Jana-Marie/OtterControlNG/README.md

# OttercontrolNG

Next generation of OtterControl, based on the STM32G431 and STMBL. Increased power density though an aluminum PCB power stage.

(not 100% working/tested yet, firmware to be released soon)

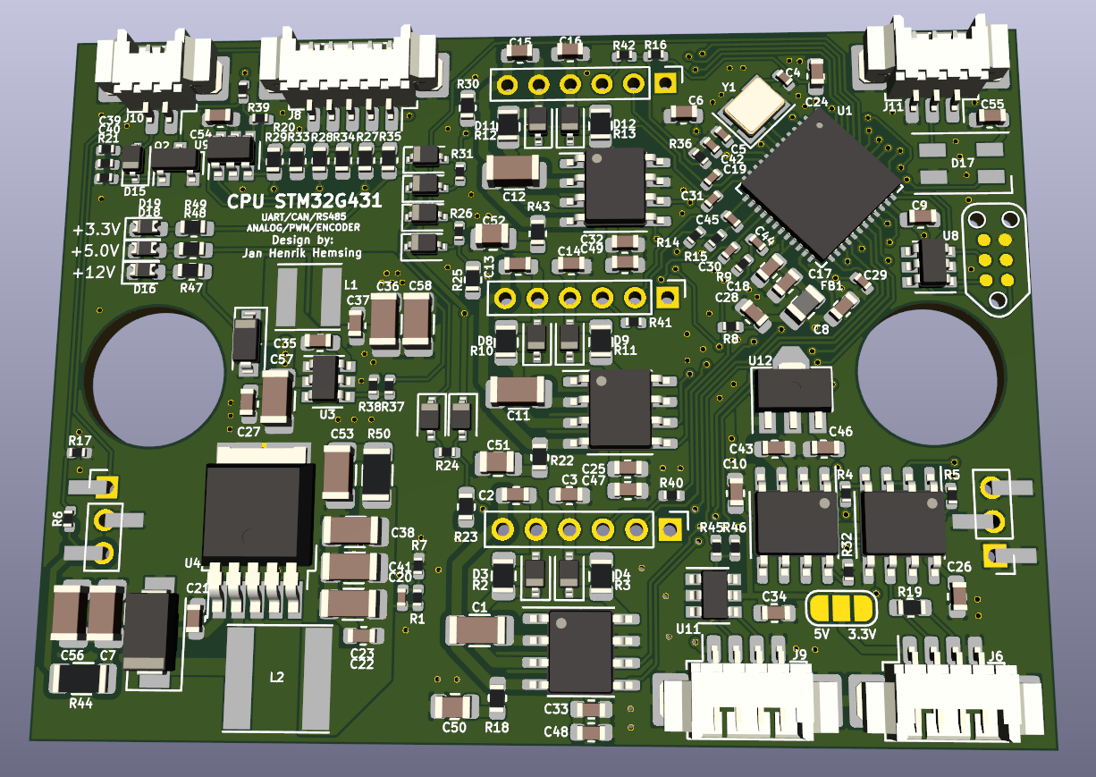
[picture p1: STM32G431/STM32G431.png]


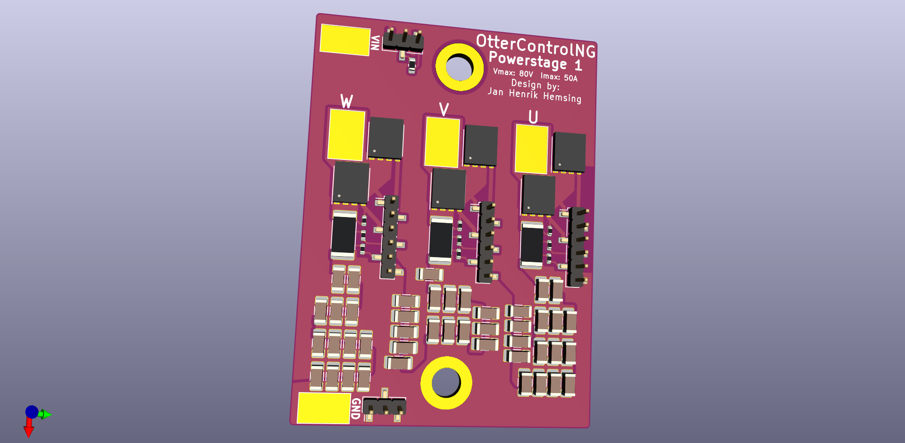
[picture p2: AluPCB/AluPCB_PowerStage1_1.png]
