Jana-Marie/OtterControlNG/AluPCB/README.md

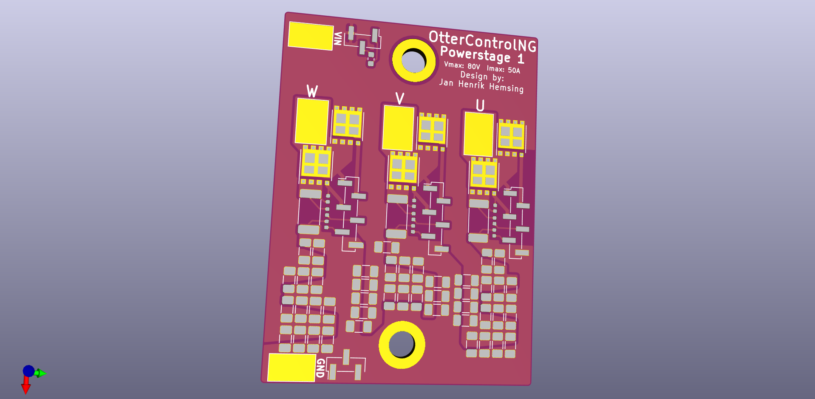
[picture p3: AluPCB/AluPCB_PowerStage1_2.png]
