Jana-Marie/OtterControlNG/(list of files, cad)

Other CAD files:
AluPCB/AluPCB-F_Paste_100.dxf
AluPCB/AluPCB-F_Paste_80.dxf
AluPCB/AluPCB-F_Paste_90.dxf
