Jana-Marie/OtterControlNG/STM32G431/con-Connector, Resistors and ICs.pdf

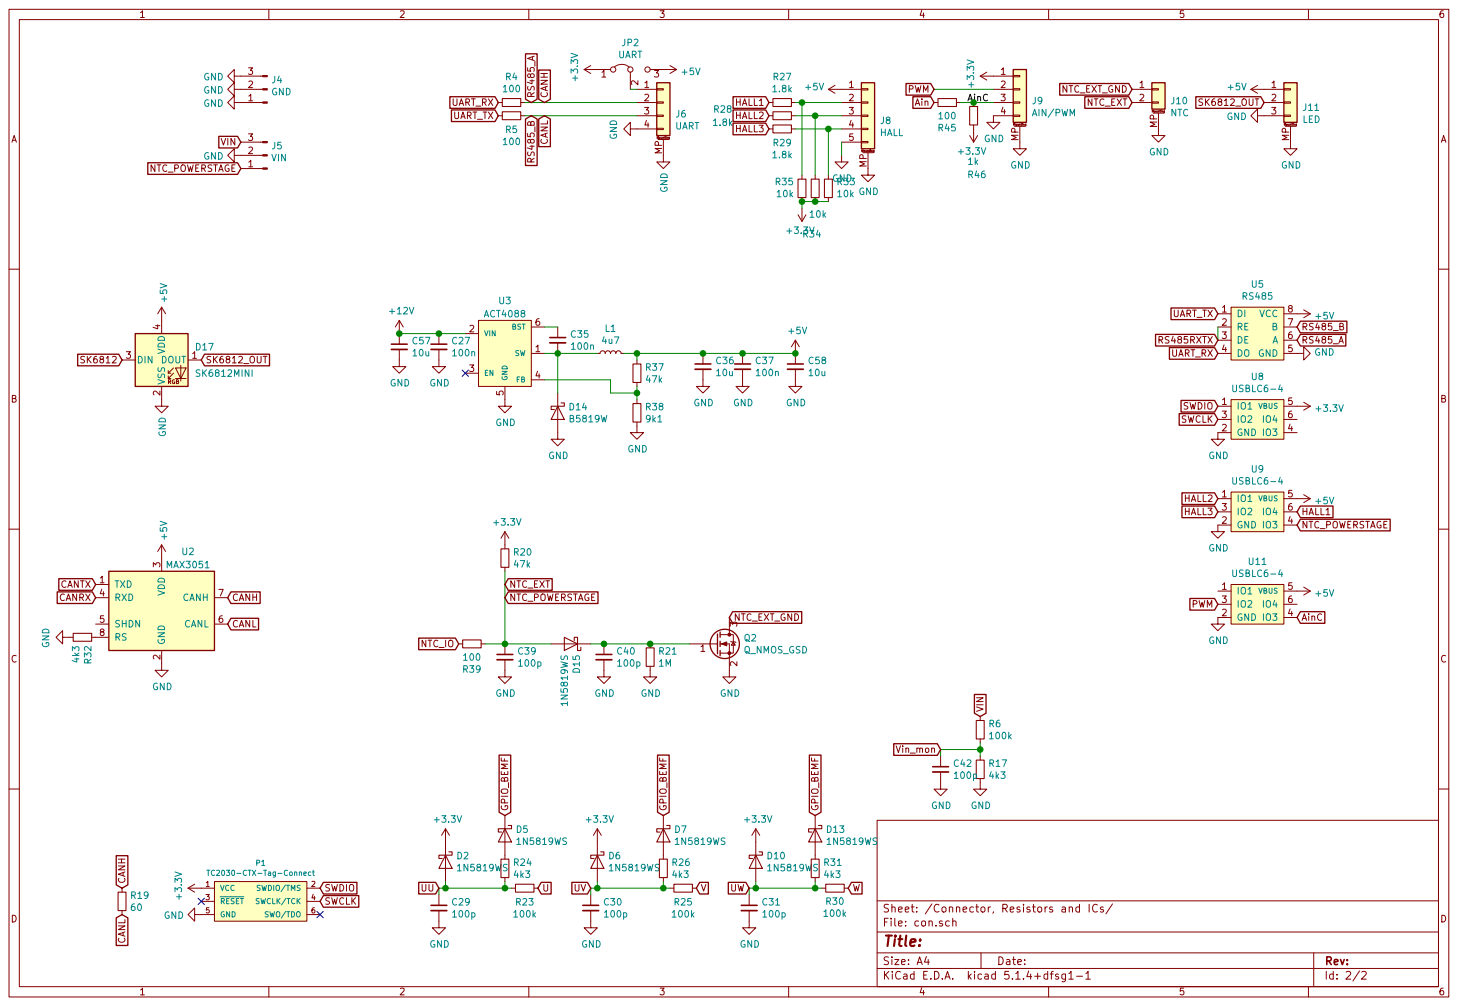
[picture p4: page 1]

3 RXD 4 SHDN 5 CANL 6 CANH 7 RS 8 U2 MAX3051 R34

Id: 2/2 Title: File: con.sch Sheet: /Connector, Resistors and ICs/
