Jana-Marie/OtterControlNG/STM32G431/STM32G431.pdf

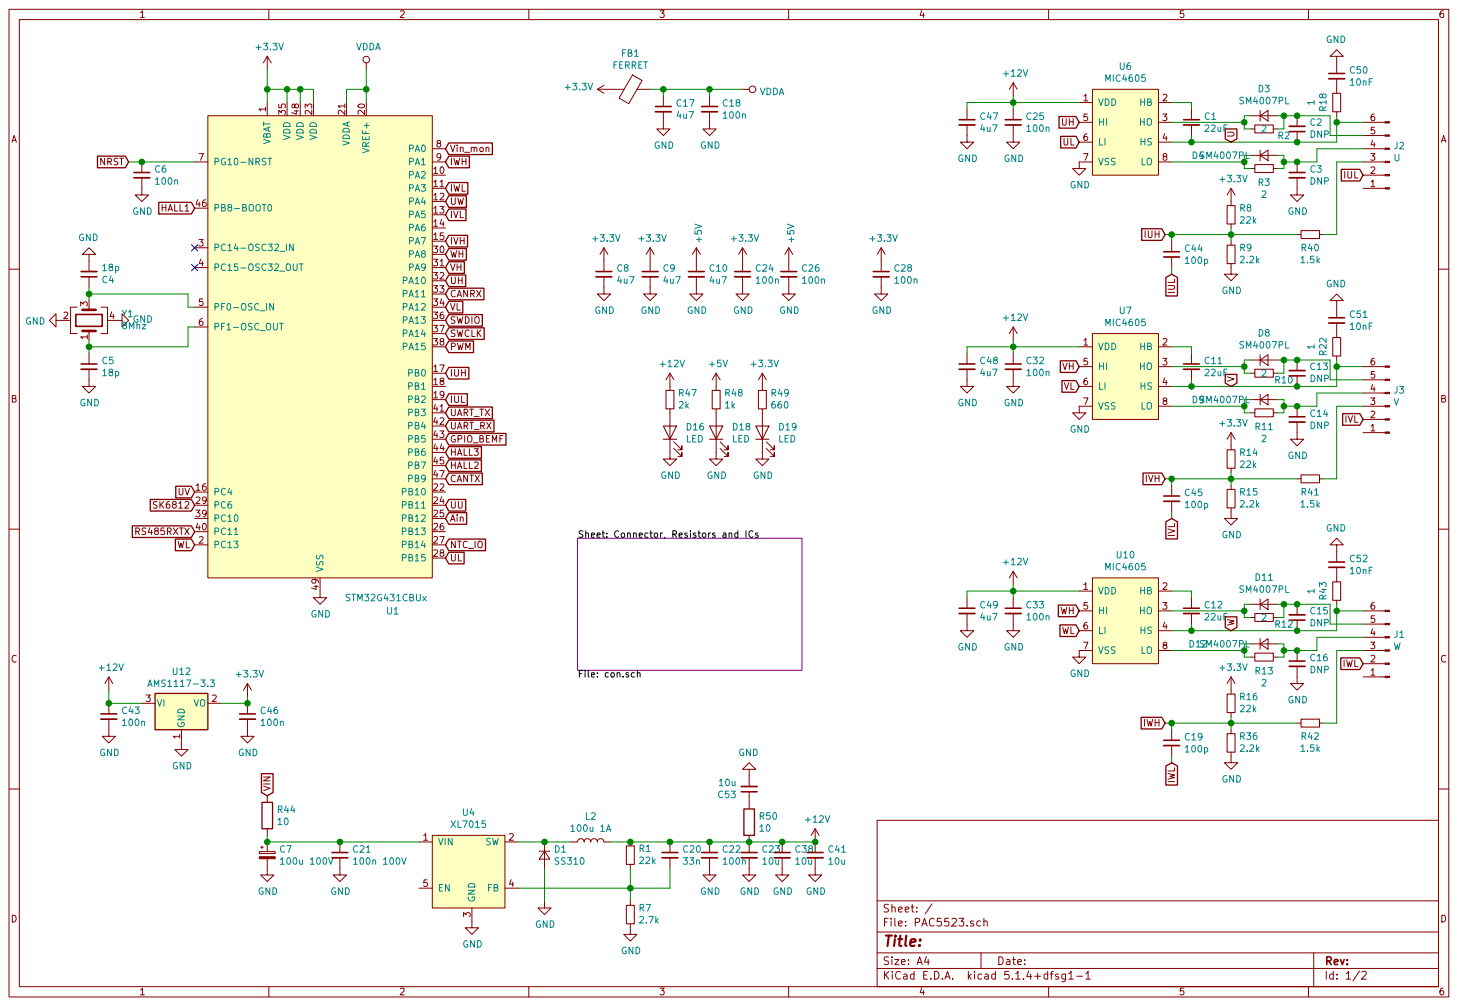
[picture p5: page 1]

1 PA2 10 PA3 11 PA4 12 PA5 13 PA6 14 PA7 15 PC4 16 PB0 17 PB1 18 PB2 19 PC13 2 VREF+ 20 VDDA 21 PB10 22 VDD 23 PB11 24 PB12 25 PB13 26 PB14 27 PB15 28 PC6 29 PC14-OSC32_IN 3 PA8 30 PA9 31 PA10 32 PA11 33 PA12 34 VDD 35 PA13 36 PA14 37 PA15 38 PC10 39 PC15-OSC32_OUT 4 PC11 40 PB3 41 PB4 42 PB5 43 PB6 44 PB7 45 PB8-BOOT0 46 PB9 47 VDD 48 VSS 49 PF0-OSC_IN 5 PF1-OSC_OUT 6 PG10-NRST 7 PA0 8 PA1 9 U1 STM32G431CBUx

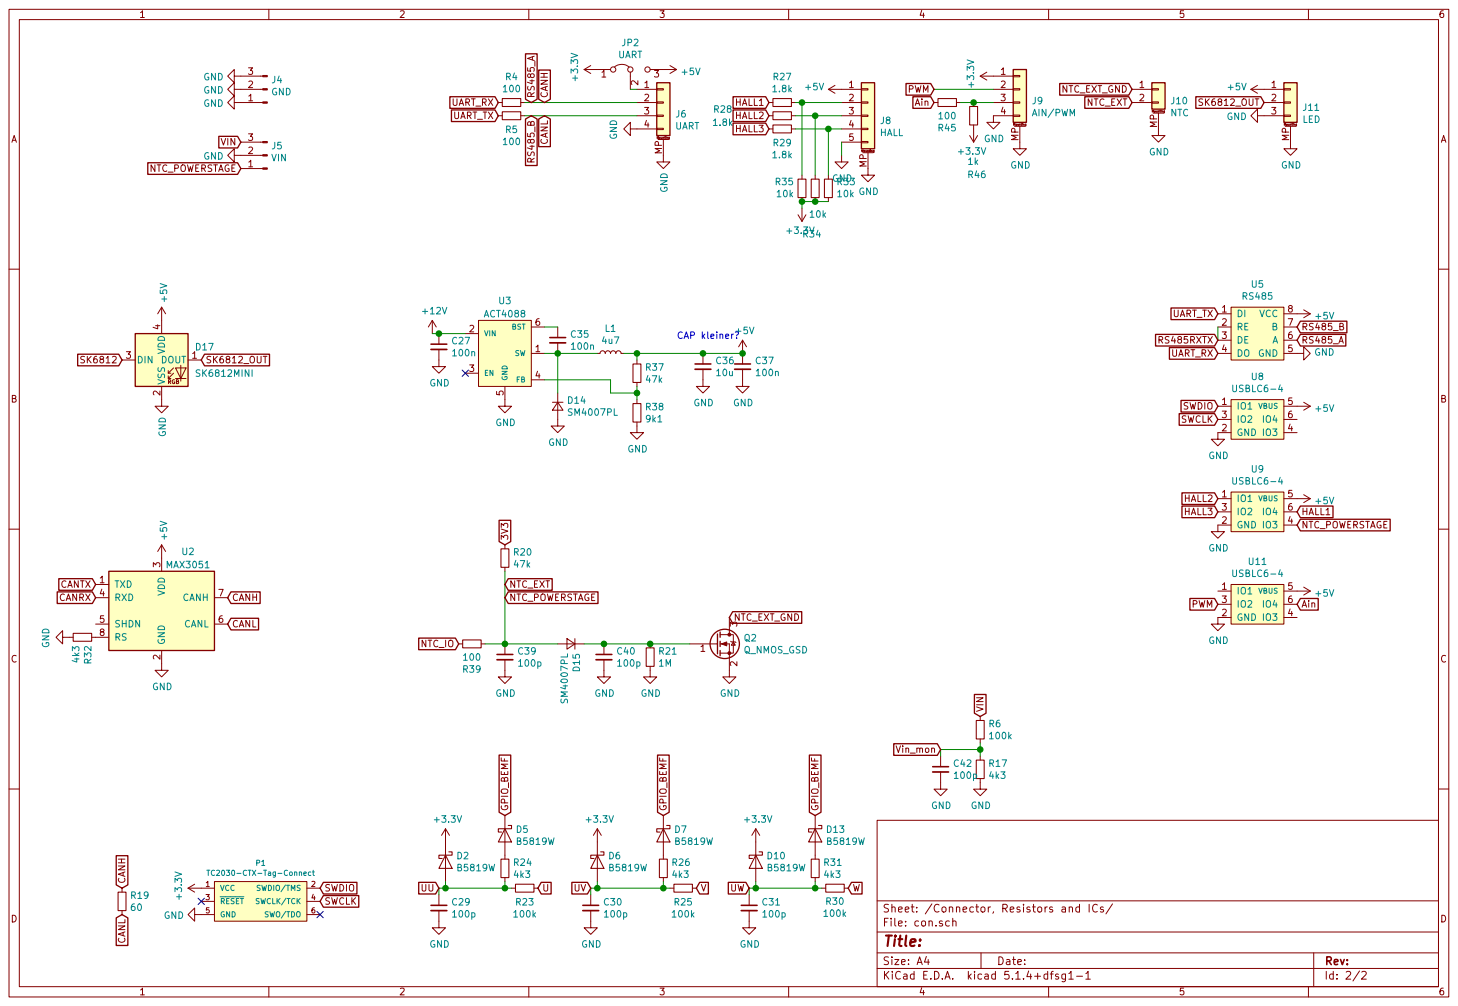
[picture p6: page 2]

3 RXD 4 SHDN 5 CANL 6 CANH 7 RS 8 U2 MAX3051 GND
