Jana-Marie/OtterControlNG/PAC5523/PAC5523.pdf

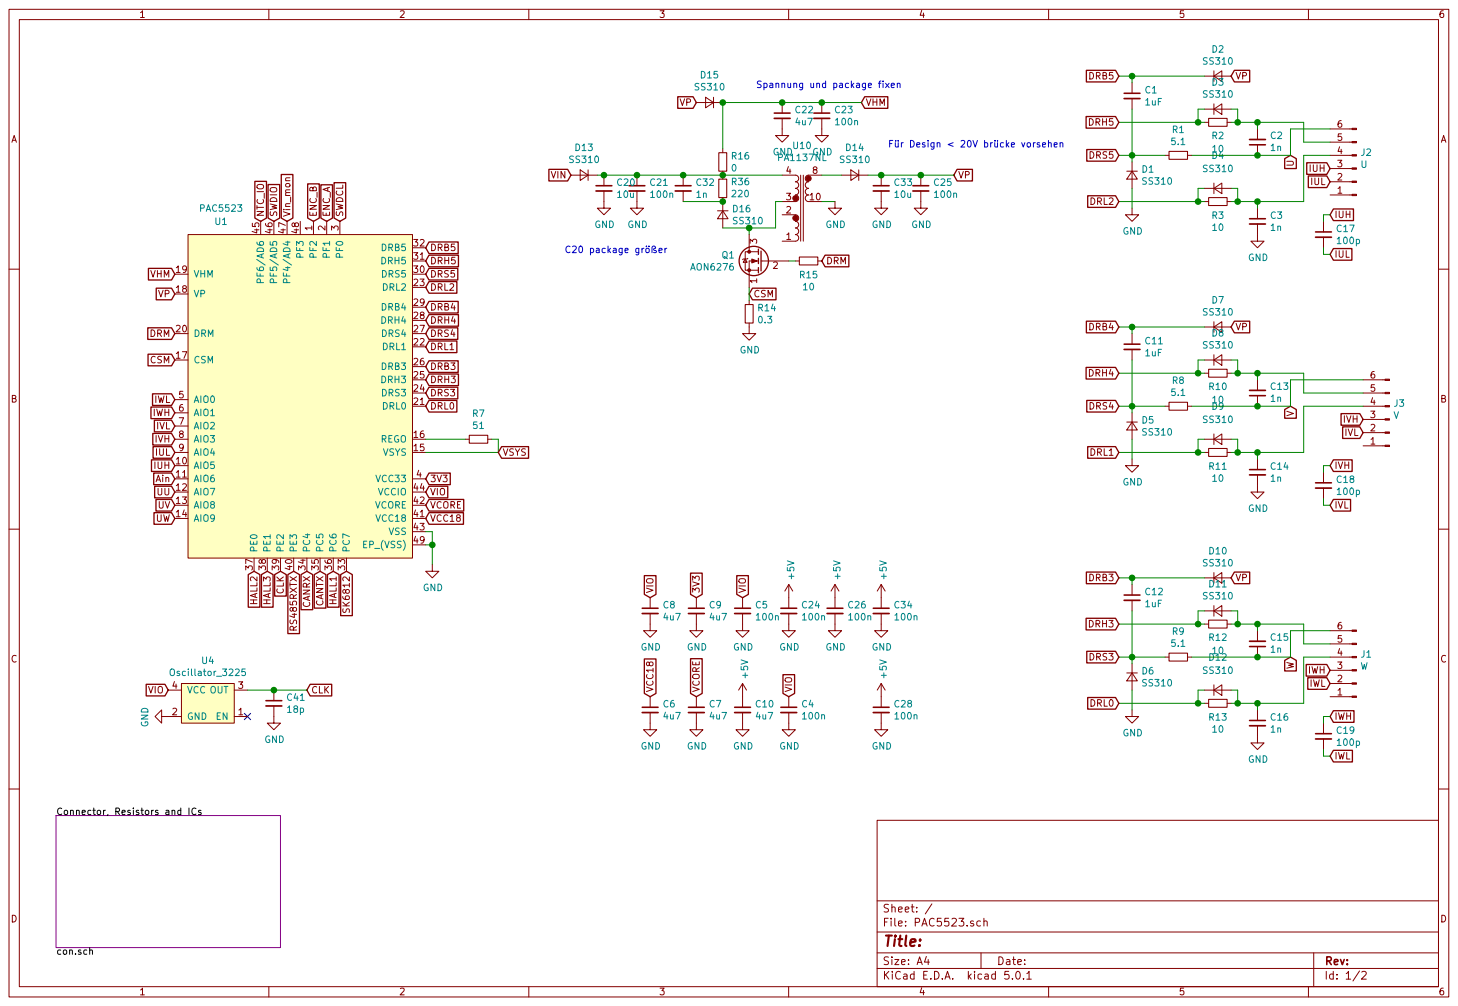
[picture p7: page 1]

Spannung und package fixen

Für Design < 20V brücke vorsehen

1 AIO5 10 AIO6 11 AIO7 12 AIO8 13 AIO9 14 VSYS 15 REGO 16 CSM 17 VP 18 VHM 19 PF1

Id: 1/2 Title: File: PAC5523.sch Sheet: / PF2

4u7 Connector, Resistors and ICs

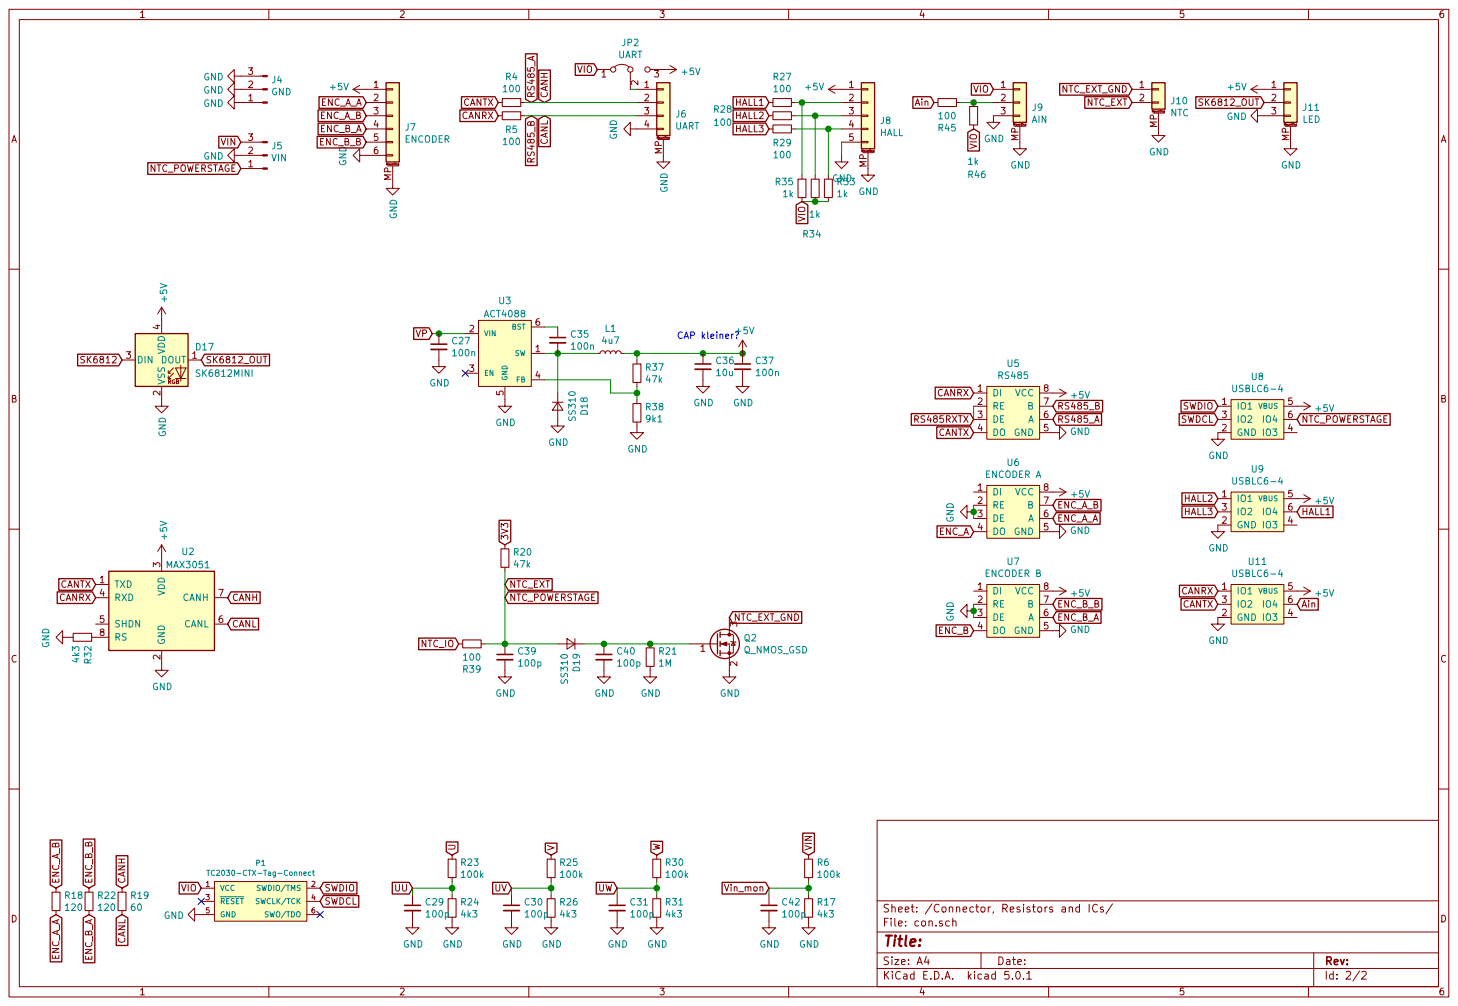
[picture p8: page 2]

JP2 UART GND GND GND

Ain GND GND GND

3 RXD 4 SHDN 5 CANL 6 CANH 7 RS 8 U2 MAX3051 GND 4k3 R32 GND

Id: 2/2 Title: File: con.sch Sheet: /Connector, Resistors and ICs/
