Jana-Marie/OtterControlNG/AluPCB/AluPCB.pdf

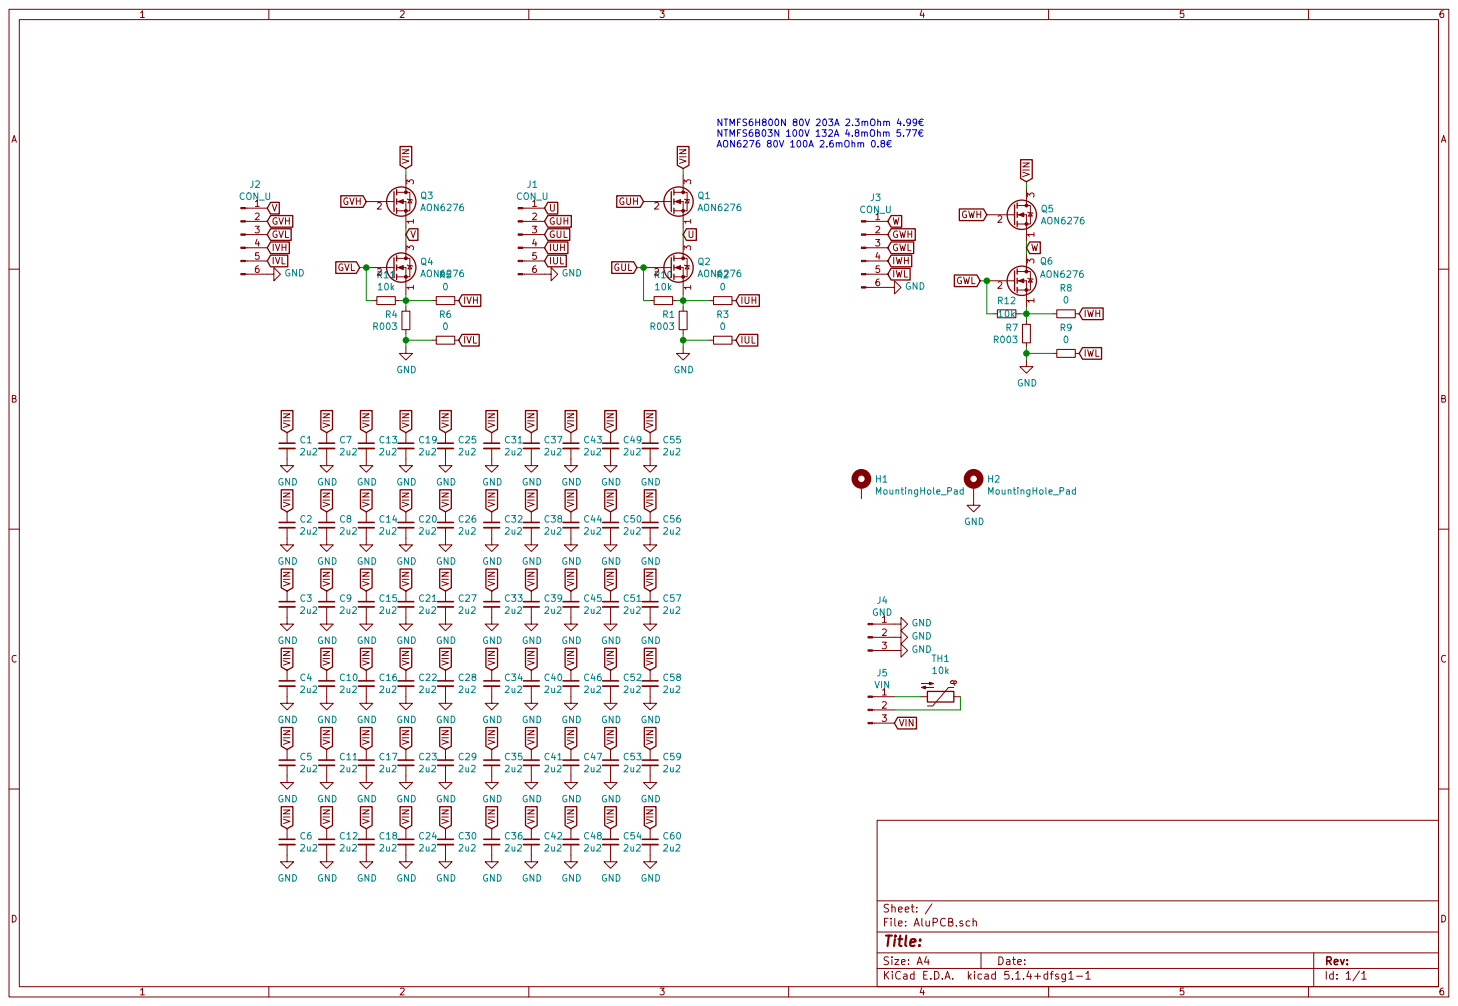
[picture p12: page 1]

Id: 1/1 Title: File: AluPCB.sch Sheet: /
