Jana-Marie/OtterControlNG/STM32G431/STM32G431.kicad_pcb

## KiCad design STM32G431/STM32G431.kicad_pcb (2020-01-31)

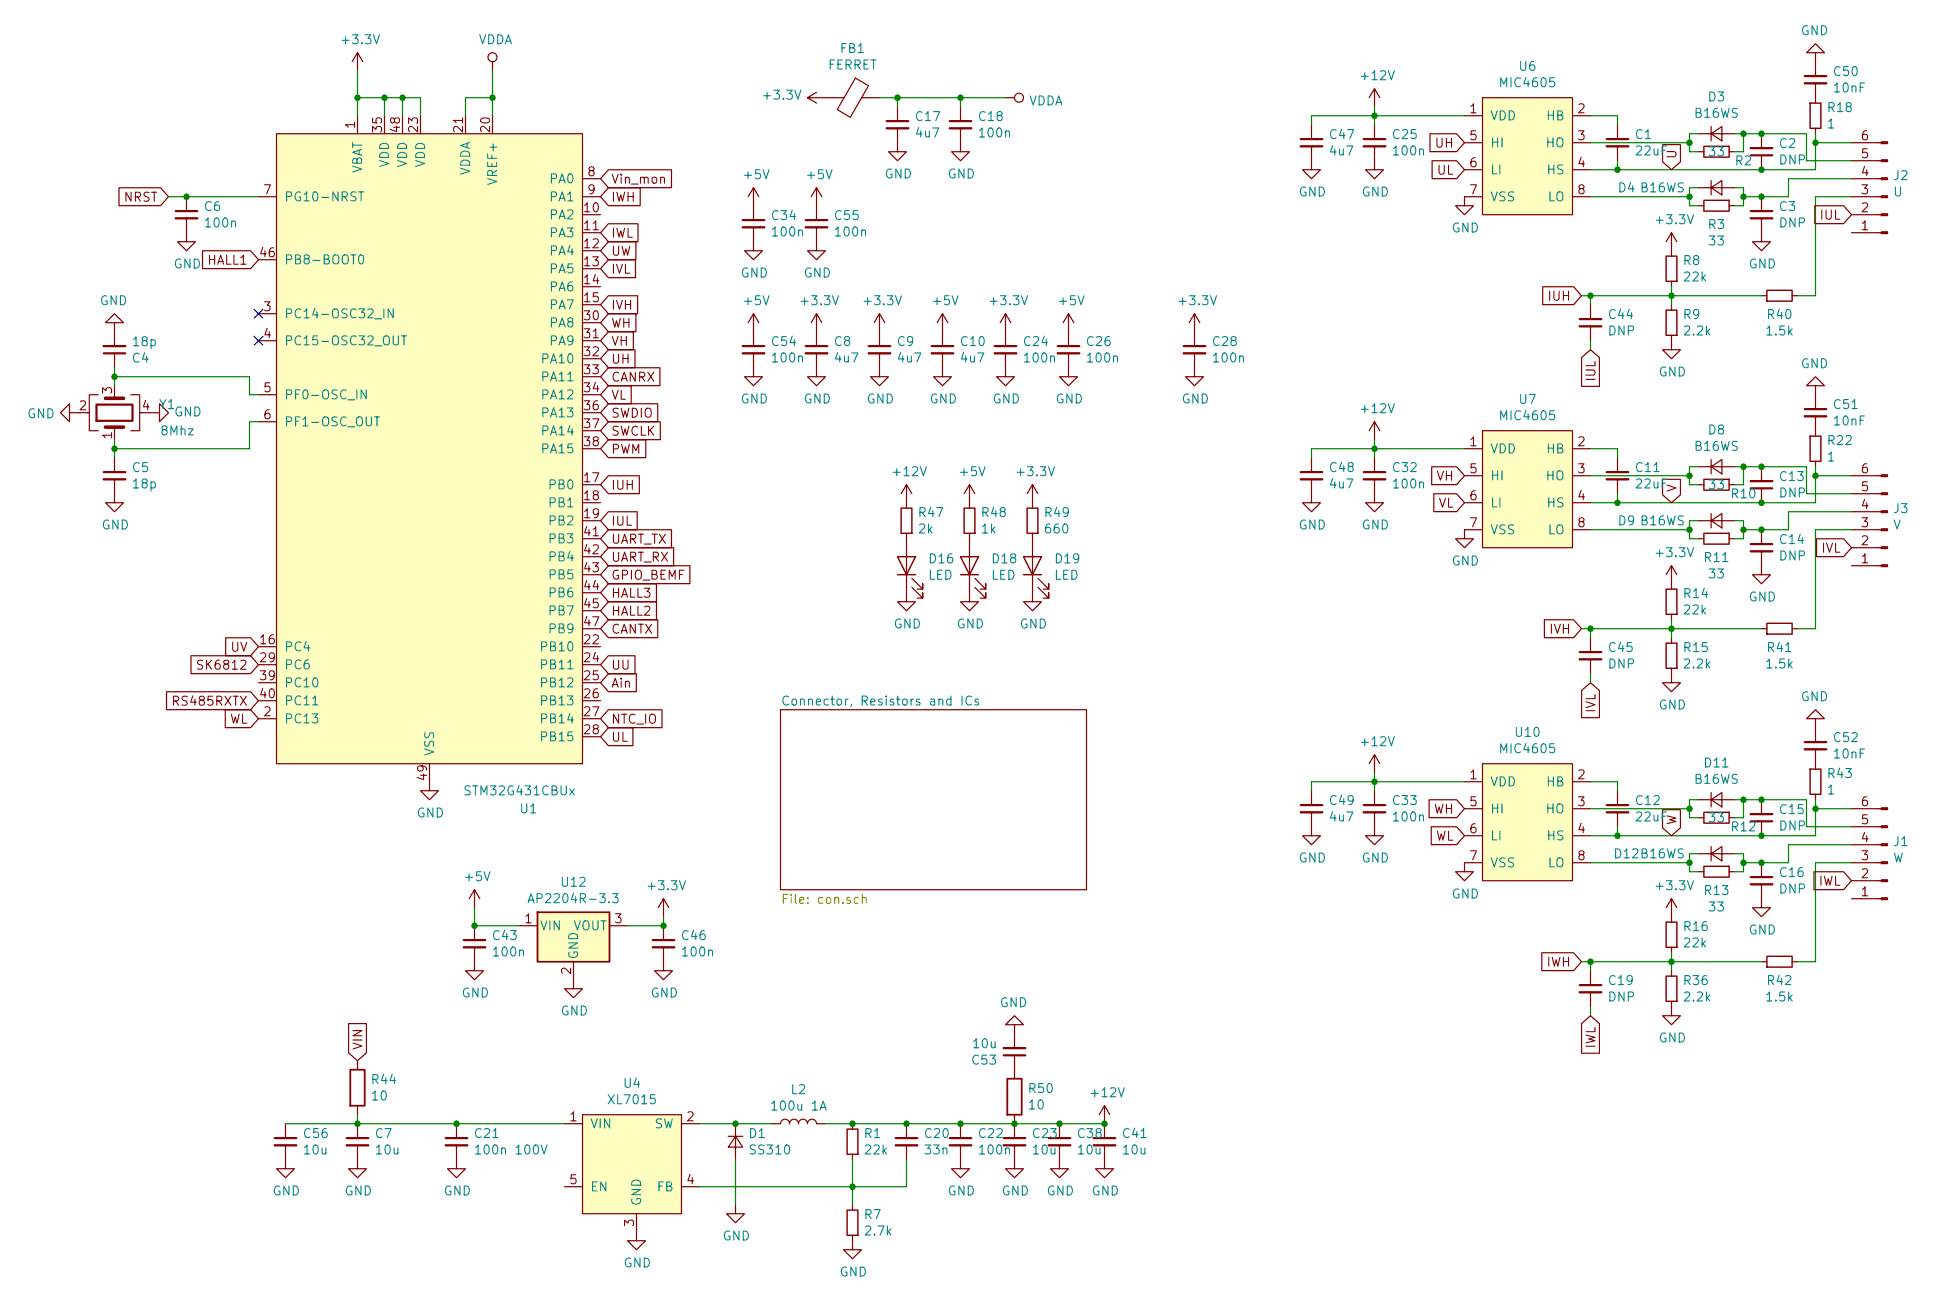
[picture p13: schematic STM32G431.sch]

Parts:
C1, C11, C12: 22uF; C_1206_3216Metric
C2, C3, C13, C14, C15, C16: DNP; C_0603_1608Metric
C4, C5: 18p; C_0402_1005Metric
C6, C18, C22, C24, C25, C26, C28, C32, C33, C34, C43, C46, C54, C55: 100n; C_0603_1608Metric
C7, C23, C38, C41, C53, C56: 10u; C_1206_3216Metric
C8, C9, C10, C17, C47, C48, C49: 4u7; C_0603_1608Metric
C19, C44, C45: DNP; C_0402_1005Metric
C20: 33n; C_0402_1005Metric
C21: 100n 100V; C_0603_1608Metric
C50, C51, C52: 10nF; C_0805_2012Metric
D1: SS310; D_SMA; LCSC C14996
D3, D4, D9, D11, D12: B16WS; D_SOD-323
D8: B16WS; D_SOD-323; LCSC C64898
D16, D18, D19: LED; D_0603_1608Metric
FB1: FERRET; L_0805_2012Metric
J1: W; PinHeader_1x06_P2.00mm_Vertical
J2: U; PinHeader_1x06_P2.00mm_Vertical
J3: V; PinHeader_1x06_P2.00mm_Vertical
L2: 100u 1A; L_Taiyo-Yuden_NR-60xx
R1, R8, R14, R16: 22k; R_0402_1005Metric
R2, R3, R10, R11, R12, R13: 33; R_0805_2012Metric
R7: 2.7k; R_0402_1005Metric
R9, R15, R36: 2.2k; R_0402_1005Metric
R18, R22, R43: 1; R_0603_1608Metric
R40, R41, R42: 1.5k; R_0402_1005Metric
R44, R50: 10; R_1206_3216Metric
R47: 2k; R_0603_1608Metric
R48: 1k; R_0603_1608Metric
R49: 660; R_0603_1608Metric
U1: STM32G431CBUx; QFN-48-1EP_7x7mm_P0.5mm_EP5.3x5.3mm
U4: XL7015; TO-252-5_TabPin3
U6, U7, U10: MIC4605; SOIC-8_3.9x4.9mm_P1.27mm
U12: AP2204R-3.3; SOT-89-3
Y1: 8Mhz; Crystal_SMD_3225-4Pin_3.2x2.5mm

Connections:
+3V3: C8.1, C9.1, C24.1, C28.1, C46.1, FB1.2, R8.2, R14.2, R16.2, R49.2, U1.1 (VBAT), U1.23 (VDD), U1.35 (VDD), U1.48 (VDD), U12.3 (VOUT); also elsewhere on the board
+5V: C10.1, C26.1, C34.1, C43.1, C54.1, C55.1, R48.2, U12.1 (VIN); also elsewhere on the board
+12V: C20.1, C22.1, C23.1, C25.1, C32.1, C33.1, C38.1, C41.1, C47.1, C48.1, C49.1, L2.2, R1.2, R47.2, R50.2, U6.1 (VDD), U7.1 (VDD), U10.1 (VDD); also elsewhere on the board
Ain: U1.25 (PB12); also elsewhere on the board
CANRX: U1.33 (PA11); also elsewhere on the board
CANTX: U1.47 (PB9); also elsewhere on the board
GND: C3.2, C4.2, C5.2, C6.2, C7.2, C8.2, C9.2, C10.2, C14.2, C16.2, C17.2, C18.2, C21.2, C22.2, C23.2, C24.2, C25.2, C26.2, C28.2, C32.2, C33.2, C34.2, C38.2, C41.2, C43.2, C46.2, C47.2, C48.2, C49.2, C50.1, C51.1, C52.1, C53.2, C54.2, C55.2, C56.2, D1.2 (A), D16.1 (K), D18.1 (K), D19.1 (K), R7.1, R9.1, R15.1, R36.1, U1.49 (VSS), U4.3 (GND), U6.7 (VSS), U7.7 (VSS), U10.7 (VSS), U12.2 (GND), Y1.2, Y1.4; also elsewhere on the board
GPIO_BEMF: U1.43 (PB5); also elsewhere on the board
HALL1: U1.46 (PB8-BOOT0); also elsewhere on the board
HALL2: U1.45 (PB7); also elsewhere on the board
HALL3: U1.44 (PB6); also elsewhere on the board
IUH: C44.1, R8.1, R9.2, R40.1, U1.17 (PB0)
IUL: C44.2, J2.2, U1.19 (PB2)
IVH: C45.1, R14.1, R15.2, R41.1, U1.15 (PA7)
IVL: C45.2, J3.2, U1.13 (PA5)
IWH: C19.1, R16.1, R36.2, R42.1, U1.9 (PA1)
IWL: C19.2, J1.2, U1.11 (PA3)
NRST: C6.1, U1.7 (PG10-NRST)
NTC_IO: U1.27 (PB14); also elsewhere on the board
unnamed: C1.1, U6.2 (HB)
unnamed: C2.2, D3.2 (A), J2.5, R2.1
unnamed: C3.1, D4.2 (A), J2.4, R3.1
unnamed: C4.1, U1.5 (PF0-OSC_IN), Y1.3
unnamed: C5.1, U1.6 (PF1-OSC_OUT), Y1.1
unnamed: C11.1, U7.2 (HB)
unnamed: C12.1, U10.2 (HB)
unnamed: C13.2, D8.2 (A), J3.5, R10.1
unnamed: C14.1, D9.2 (A), J3.4, R11.1
unnamed: C15.2, D11.2 (A), J1.5, R12.1
unnamed: C16.1, D12.2 (A), J1.4, R13.1
unnamed: C20.2, R1.1, R7.2, U4.4 (FB)
unnamed: C7.1, C21.1, C56.1, R44.2, U4.1 (VIN)
unnamed: C50.2, R18.1
unnamed: C51.2, R22.1
unnamed: C52.2, R43.1
unnamed: C53.1, R50.1
unnamed: D1.1 (K), L2.1, U4.2 (SW)
unnamed: D3.1 (K), R2.2, U6.3 (HO)
unnamed: D4.1 (K), R3.2, U6.8 (LO)
unnamed: D8.1 (K), R10.2, U7.3 (HO)
unnamed: D9.1 (K), R11.2, U7.8 (LO)
unnamed: D11.1 (K), R12.2, U10.3 (HO)
unnamed: D12.1 (K), R13.2, U10.8 (LO)
unnamed: D16.2 (A), R47.1
unnamed: D18.2 (A), R48.1
unnamed: D19.2 (A), R49.1
unnamed: J1.3, R42.2
unnamed: J2.3, R40.2
unnamed: J3.3, R41.2
PWM: U1.38 (PA15); also elsewhere on the board
RS485RXTX: U1.40 (PC11); also elsewhere on the board
SK6812: U1.29 (PC6); also elsewhere on the board
SWCLK: U1.37 (PA14); also elsewhere on the board
SWDIO: U1.36 (PA13); also elsewhere on the board
U: C1.2, C2.1, J2.6, R18.2, U6.4 (HS); also elsewhere on the board
UART_RX: U1.42 (PB4); also elsewhere on the board
UART_TX: U1.41 (PB3); also elsewhere on the board
UH: U1.32 (PA10), U6.5 (HI)
UL: U1.28 (PB15), U6.6 (LI)
UU: U1.24 (PB11); also elsewhere on the board
UV: U1.16 (PC4); also elsewhere on the board
UW: U1.12 (PA4); also elsewhere on the board
V: C11.2, C13.1, J3.6, R22.2, U7.4 (HS); also elsewhere on the board
VDDA: C17.1, C18.1, FB1.1, U1.20 (VREF+), U1.21 (VDDA)
VH: U1.31 (PA9), U7.5 (HI)
VIN: R44.1; also elsewhere on the board
VL: U1.34 (PA12), U7.6 (LI)
Vin_mon: U1.8 (PA0); also elsewhere on the board
W: C12.2, C15.1, J1.6, R43.2, U10.4 (HS); also elsewhere on the board
WH: U1.30 (PA8), U10.5 (HI)
WL: U1.2 (PC13), U10.6 (LI)

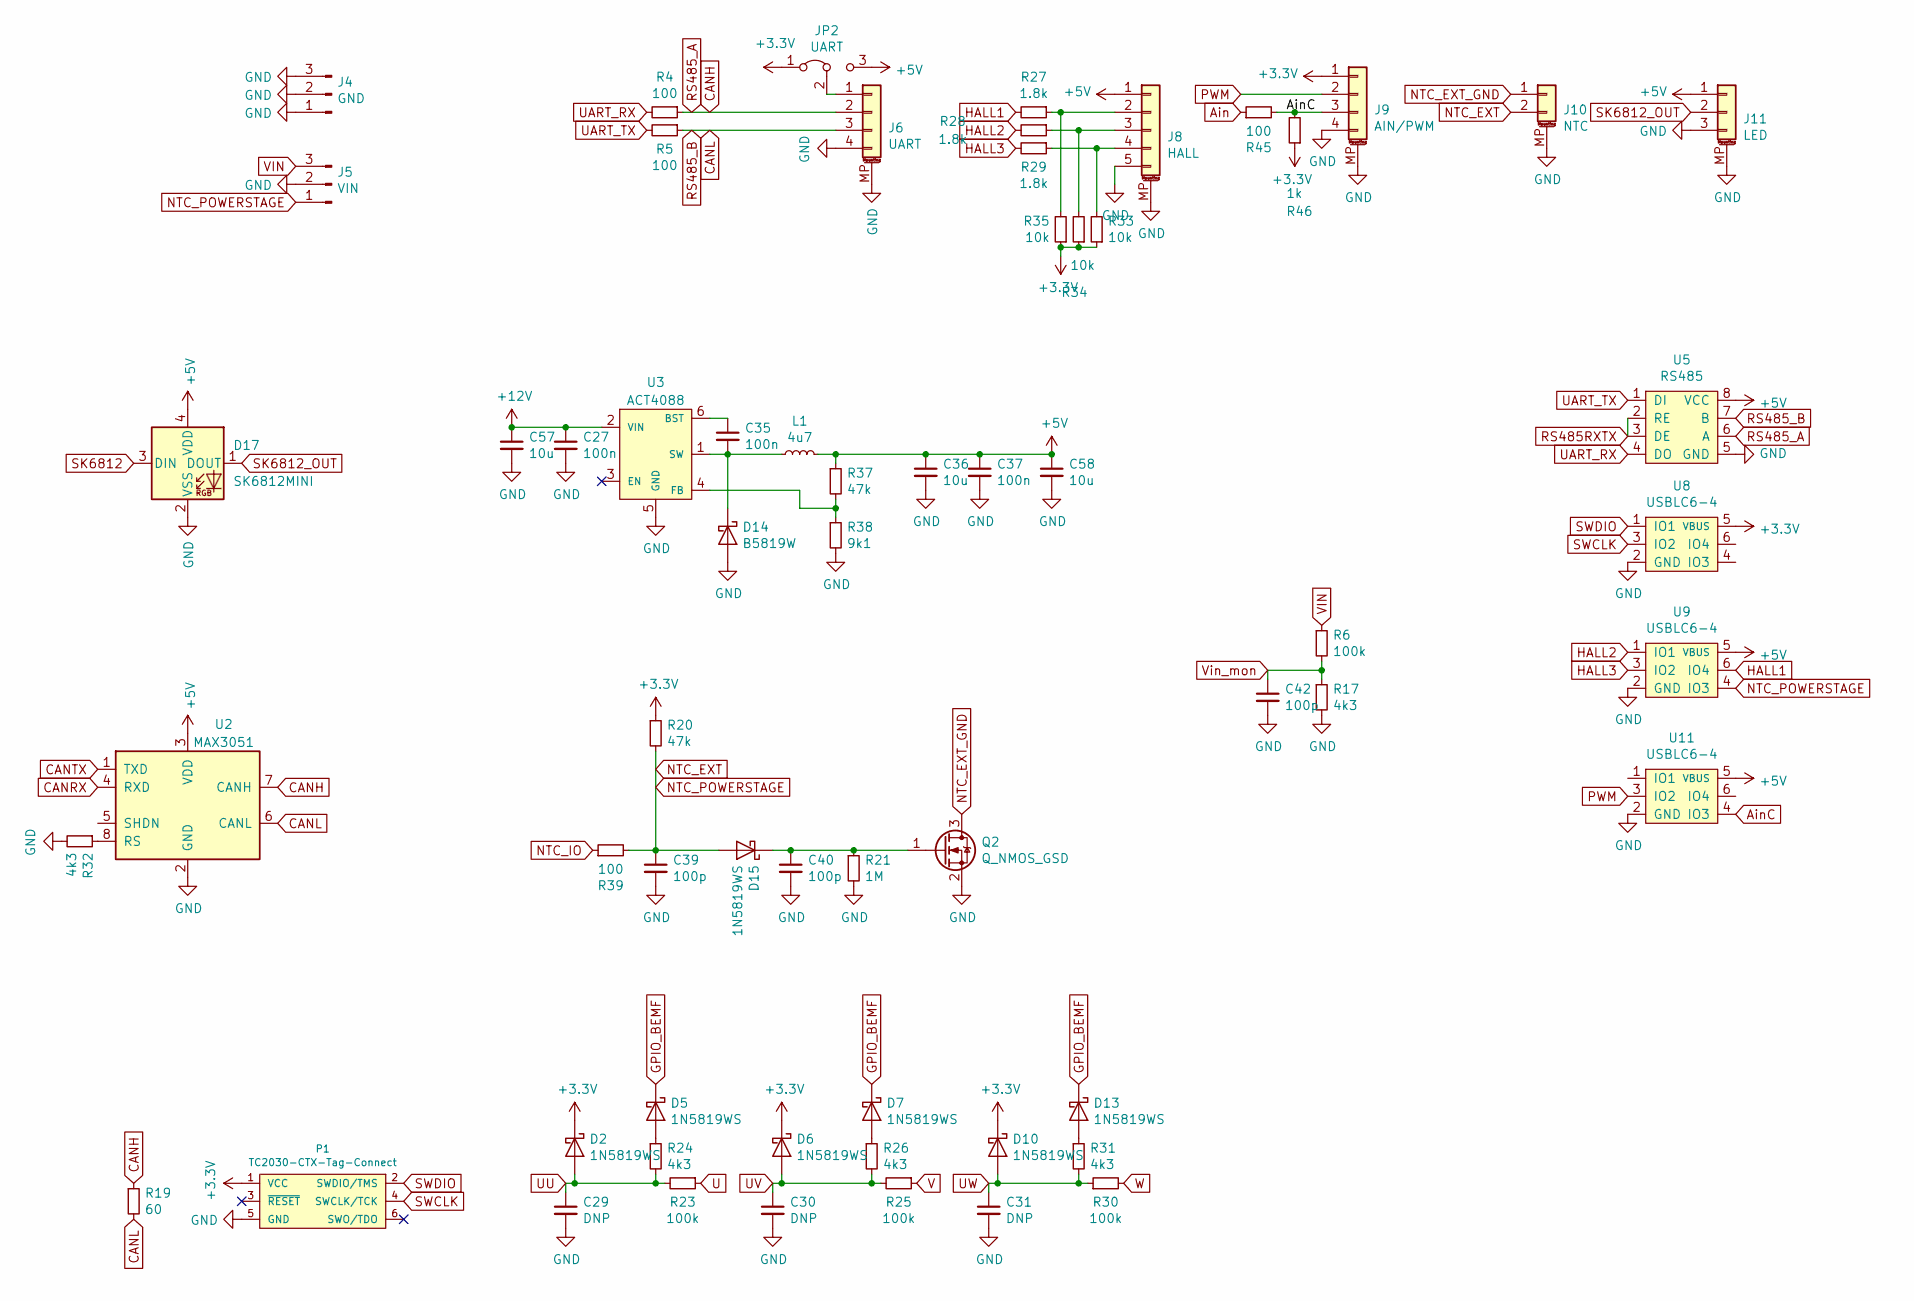
[picture p14: schematic con.sch]

Parts:
C27, C35, C37: 100n; C_0603_1608Metric
C29, C30, C31: DNP; C_0402_1005Metric
C36, C57, C58: 10u; C_1206_3216Metric
C39, C40, C42: 100p; C_0402_1005Metric
D2, D5, D6, D7, D10, D13, D15: 1N5819WS; D_SOD-323; LCSC C8598
D14: B5819W; D_SOD-123; LCSC C8598
D17: SK6812MINI; LED_SK6812MINI_PLCC4_3.5x3.5mm_P1.75mm
J4: GND; PinHeader_1x03_P2.00mm_Vertical_COMBI
J5: VIN; PinHeader_1x03_P2.00mm_Vertical_COMBI
J6: UART; Molex_PicoBlade_53261-0471_1x04-1MP_P1.25mm_Horizontal
J8: HALL; Molex_PicoBlade_53261-0571_1x05-1MP_P1.25mm_Horizontal
J9: AIN/PWM; Molex_PicoBlade_53261-0471_1x04-1MP_P1.25mm_Horizontal
J10: NTC; Molex_PicoBlade_53261-0271_1x02-1MP_P1.25mm_Horizontal
J11: LED; Molex_PicoBlade_53261-0371_1x03-1MP_P1.25mm_Horizontal
JP2: UART; SolderJumper-3_P1.3mm_Open_RoundedPad1.0x1.5mm
L1: 4u7; L_Taiyo-Yuden_MD-4040
P1: TC2030-CTX-Tag-Connect; TC2030
Q2: Q_NMOS_GSD; SOT-23
R4, R5, R39, R45: 100; R_0402_1005Metric
R6: 100k; R_0402_1005Metric
R17, R24, R26, R31, R32: 4k3; R_0402_1005Metric
R19: 60; R_0603_1608Metric
R20, R37: 47k; R_0402_1005Metric
R21: 1M; R_0402_1005Metric
R23, R25, R30: 100k; R_0603_1608Metric
R27, R28, R29: 1.8k; R_0603_1608Metric
R33, R34, R35: 10k; R_0603_1608Metric
R38: 9k1; R_0402_1005Metric
R46: 1k; R_0402_1005Metric
U2: MAX3051; SOIC-8_3.9x4.9mm_P1.27mm
U3: ACT4088; SOT-23-6
U5: RS485; SOIC-8_3.9x4.9mm_P1.27mm
U8, U9, U11: USBLC6-4; SOT-23-6

Connections:
+3V3: D2.1 (K), D6.1 (K), D10.1 (K), J9.1, JP2.1 (A), P1.1 (VCC), R20.1, R33.1, R34.1, R35.1, R46.1, U8.5 (VBUS); also elsewhere on the board
+5V: C36.1, C37.1, C58.1, D17.4 (VDD), J8.1, J11.1, JP2.3 (B), L1.2, R37.1, U2.3 (VDD), U5.8 (VCC), U9.5 (VBUS), U11.5 (VBUS); also elsewhere on the board
+12V: C27.1, C57.1, U3.2 (VIN); also elsewhere on the board
Ain: R45.1; also elsewhere on the board
AinC: J9.3, R45.2, R46.2, U11.4 (IO3)
CANH: J6.2, R4.1, R19.1, U2.7 (CANH), U5.6 (A)
CANL: J6.3, R5.1, R19.2, U2.6 (CANL), U5.7 (B)
CANRX: U2.4 (RXD); also elsewhere on the board
CANTX: U2.1 (TXD); also elsewhere on the board
GND: C27.2, C29.2, C30.2, C31.2, C36.2, C37.2, C39.2, C40.2, C42.2, C57.2, C58.2, D14.2 (A), D17.2 (VSS), J4.1, J4.2, J4.3, J5.2, J6.4, J6.MP (MountPin), J8.5, J8.MP (MountPin), J9.4, J9.MP (MountPin), J10.MP (MountPin), J11.3, J11.MP (MountPin), P1.5 (GND), Q2.2 (S), R17.2, R21.2, R32.2, R38.2, U2.2 (GND), U3.5 (GND), U5.5 (GND), U8.2 (GND), U9.2 (GND), U11.2 (GND); also elsewhere on the board
GPIO_BEMF: D5.1 (K), D7.1 (K), D13.1 (K); also elsewhere on the board
HALL1: R27.2, U9.6 (IO4); also elsewhere on the board
HALL2: R28.2, U9.1 (IO1); also elsewhere on the board
HALL3: R29.2, U9.3 (IO2); also elsewhere on the board
NTC_EXT: C39.1, D15.2 (A), J5.1, J10.2, R20.2, R39.2, U9.4 (IO3)
NTC_EXT_GND: J10.1, Q2.3 (D)
NTC_IO: R39.1; also elsewhere on the board
unnamed: C35.1, U3.6 (BST)
unnamed: C35.2, D14.1 (K), L1.1, U3.1 (SW)
unnamed: C40.1, D15.1 (K), Q2.1 (G), R21.1
unnamed: D5.2 (A), R24.1
unnamed: D7.2 (A), R26.1
unnamed: D13.2 (A), R31.1
unnamed: J6.1, JP2.2 (C)
unnamed: J8.2, R27.1, R35.2
unnamed: J8.3, R28.1, R34.2
unnamed: J8.4, R29.1, R33.2
unnamed: R32.1, U2.8 (RS)
unnamed: R37.2, R38.1, U3.4 (FB)
PWM: J9.2, U11.3 (IO2); also elsewhere on the board
RS485RXTX: U5.2 (RE), U5.3 (DE); also elsewhere on the board
SK6812: D17.3 (DIN); also elsewhere on the board
SK6812_OUT: D17.1 (DOUT), J11.2
SWCLK: P1.4 (SWCLK/TCK), U8.3 (IO2); also elsewhere on the board
SWDIO: P1.2 (SWDIO/TMS), U8.1 (IO1); also elsewhere on the board
U: R23.1; also elsewhere on the board
UART_RX: R4.2, U5.4 (DO); also elsewhere on the board
UART_TX: R5.2, U5.1 (DI); also elsewhere on the board
UU: C29.1, D2.2 (A), R23.2, R24.2; also elsewhere on the board
UV: C30.1, D6.2 (A), R25.2, R26.2; also elsewhere on the board
UW: C31.1, D10.2 (A), R30.1, R31.2; also elsewhere on the board
V: R25.1; also elsewhere on the board
VIN: J5.3, R6.1; also elsewhere on the board
Vin_mon: C42.1, R6.2, R17.1; also elsewhere on the board
W: R30.2; also elsewhere on the board

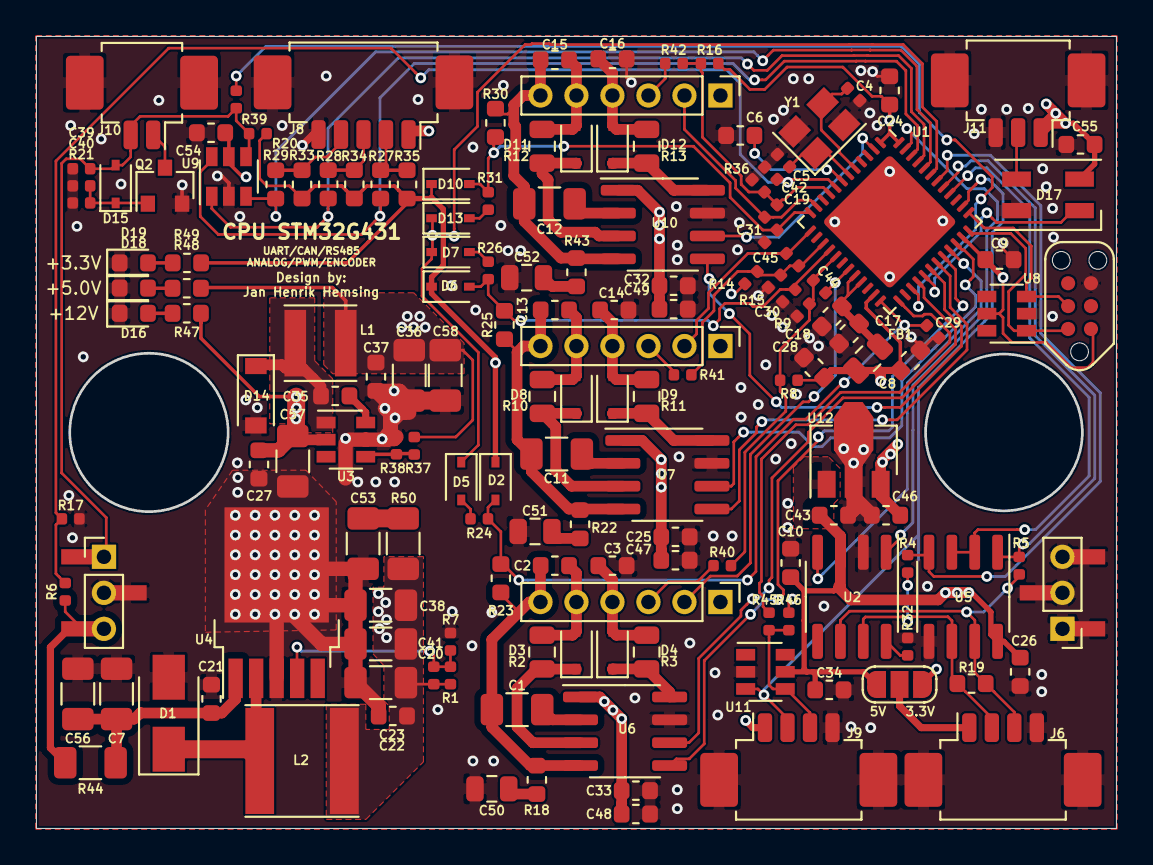
[picture p15: board STM32G431.kicad_pcb from above]

Board: 4 copper layers, 60.0 x 44.0 mm, 156 parts (0 on the bottom side), 89 nets.
