Jana-Marie/OtterControlNG/PAC5523/PAC5523.kicad_pcb

## KiCad design PAC5523/PAC5523.kicad_pcb (2019-11-15)

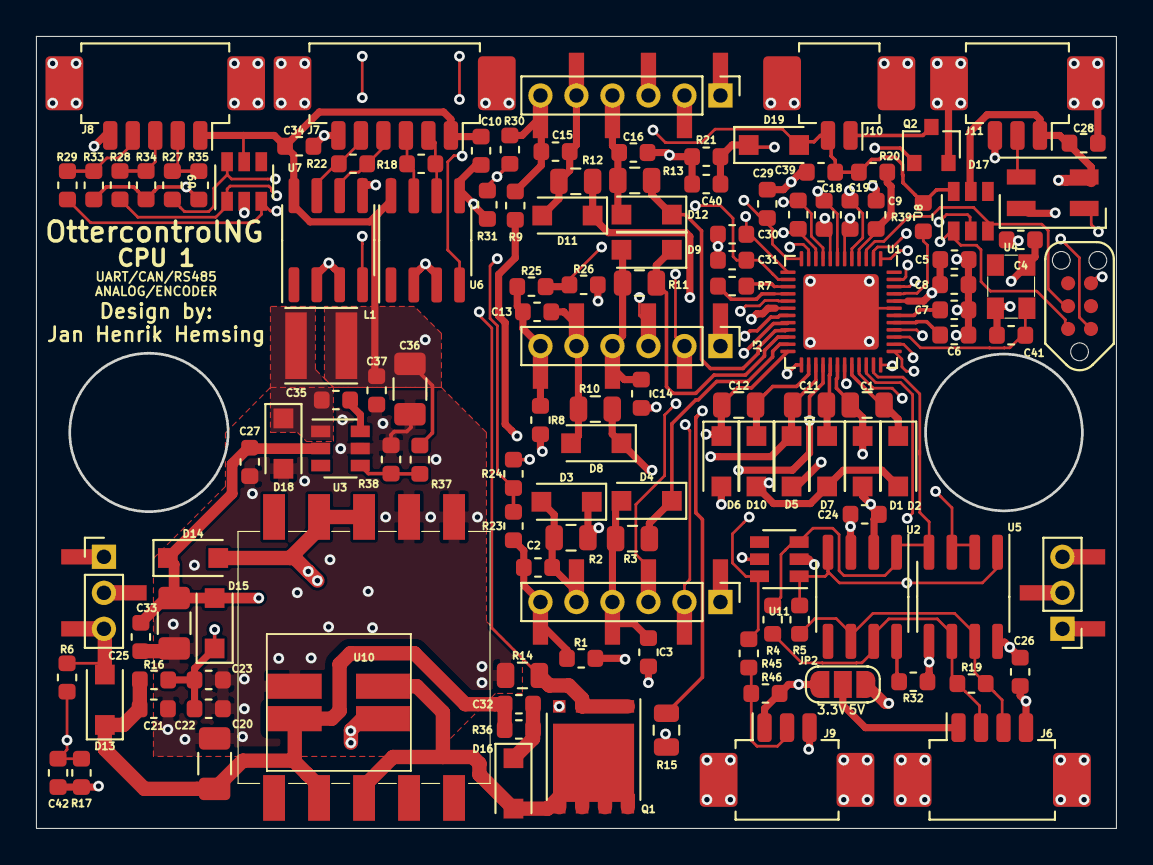
[picture p16: board PAC5523.kicad_pcb from above]

Board: 4 copper layers, 60.0 x 44.0 mm, 128 parts (0 on the bottom side), 82 nets.

Parts:
C1, C11, C12: 1uF; C_0805_2012Metric
C2, C3, C13, C14, C15, C16: TBD; C_0603_1608Metric
C4, C5, C21, C23, C24, C25, C26, C27, C28, C34, C35, C37: 100n; C_0603_1608Metric
C6, C7, C8, C9, C10, C22: 4u7; C_0603_1608Metric
C17, C18, C19, C29, C30, C31, C39, C40, C42: 100p; C_0603_1608Metric
C20, C33, C36: 10u; C_1206_3216Metric
C32: 1n; C_0603_1608Metric
C41: 18p; C_0603_1608Metric
D1, D2, D3, D4, D5, D6, D7, D8, D9, D10, D11, D12, D13, D14, D15, D16, D18, D19: SS310; D_SOD-123F
D17: SK6812MINI; LED_SK6812MINI_PLCC4_3.5x3.5mm_P1.75mm
J1: W; PinHeader_1x06_P2.00mm_Vertical_COMBI
J2: U; PinHeader_1x06_P2.00mm_Vertical_COMBI
J3: V; PinHeader_1x06_P2.00mm_Vertical_COMBI
J4: GND; PinHeader_1x03_P2.00mm_Vertical_COMBI
J5: VIN; PinHeader_1x03_P2.00mm_Vertical_COMBI
J6: UART; Molex_PicoBlade_53261-0471_1x04-1MP_P1.25mm_Horizontal
J7: ENCODER; Molex_PicoBlade_53261-0671_1x06-1MP_P1.25mm_Horizontal
J8: HALL; Molex_PicoBlade_53261-0571_1x05-1MP_P1.25mm_Horizontal
J9: AIN; Molex_PicoBlade_53261-0371_1x03-1MP_P1.25mm_Horizontal
J10: NTC; Molex_PicoBlade_53261-0271_1x02-1MP_P1.25mm_Horizontal
J11: LED; Molex_PicoBlade_53261-0371_1x03-1MP_P1.25mm_Horizontal
JP2: UART; SolderJumper-3_P1.3mm_Open_RoundedPad1.0x1.5mm
L1: 4u7; L_Taiyo-Yuden_MD-4040
P1: TC2030-CTX-Tag-Connect; TC2030
Q1: AON6276; VSONP-8-1EP_5x6_P1.27mm
Q2: Q_NMOS_GSD; SOT-23
R1, R8, R9: 5.1; R_0603_1608Metric
R2, R3, R10, R11, R12, R13, R15: 10; R_0805_2012Metric
R4, R5, R27, R28, R29, R39, R45: 100; R_0603_1608Metric
R6, R23, R25, R30: 100k; R_0603_1608Metric
R7: 51; R_0603_1608Metric
R14: 0.3; R_0805_2012Metric
R16: 0; R_0603_1608Metric
R17, R24, R26, R31, R32: 4k3; R_0603_1608Metric
R18, R22: 120; R_0603_1608Metric
R19: 60; R_0603_1608Metric
R20, R37: 47k; R_0603_1608Metric
R21: 1M; R_0603_1608Metric
R33, R34, R35, R46: 1k; R_0603_1608Metric
R36: 220; R_0603_1608Metric
R38: 9k1; R_0603_1608Metric
U1: PAC5523; QFN-48-1EP_6x6mm_P0.4mm_EP4.2x4.2mm
U2: MAX3051; SOIC-8_3.9x4.9mm_P1.27mm
U3: ACT4088; SOT-23-6
U4: Oscillator_3225
U5: RS485; SOIC-8_3.9x4.9mm_P1.27mm
U6: ENCODER A; SOIC-8_3.9x4.9mm_P1.27mm
U7: ENCODER B; SOIC-8_3.9x4.9mm_P1.27mm
U8, U9, U11: USBLC6-4; SOT-23-6
U10: PA1137NL

Connections:
3V3: C9.1, R20.1, U1.4
+5V: C10.1, C24.1, C26.1, C28.1, C34.1, C36.1, C37.1, D17.4, J7.1, J8.1, J11.1, JP2.3, L1.2, R37.1, U2.3, U5.8, U6.8, U7.8, U8.5, U9.5, U11.5
Ain: R45.1, U1.11, U11.6
CANH: J6.2, R4.1, R19.1, U2.7, U5.6
CANL: J6.3, R5.1, R19.2, U2.6, U5.7
CANRX: R5.2, U1.34, U2.4, U5.1, U11.1
CANTX: R4.2, U1.35, U2.1, U5.4, U11.3
CLK: C41.1, U1.39, U4.3
CSM: Q1.1, R14.1, U1.17
DRB3: C12.1, D10.1, U1.26
DRB4: C11.1, D7.1, U1.29
DRB5: C1.1, D2.1, U1.32
DRH3: D11.1, R12.2, U1.25
DRH4: D8.1, R10.2, U1.28
DRH5: D3.1, R2.2, U1.31
DRL0: D12.1, R13.2, U1.21
DRL1: D9.1, R11.2, U1.22
DRL2: D4.1, R3.2, U1.23
DRM: R15.1, U1.20
DRS3: C12.2, D6.1, R9.2, U1.24
DRS4: C11.2, D5.1, R8.2, U1.27
DRS5: C1.2, D1.1, R1.2, U1.30
ENC_A: U1.2, U6.4
ENC_A_A: J7.2, R18.2, U6.6
ENC_A_B: J7.3, R18.1, U6.7
ENC_B: U1.1, U7.4
ENC_B_A: J7.4, R22.2, U7.6
ENC_B_B: J7.5, R22.1, U7.7
GND: C3.2, C4.2, C5.2, C6.2, C7.2, C8.2, C9.2, C10.2, C14.2, C16.2, C20.2, C21.2, C22.2, C23.2, C24.2, C25.2, C26.2, C27.2, C28.2, C29.2, C30.2, C31.2, C33.2, C34.2, C36.2, C37.2, C39.2, C40.2, C41.2, C42.2, D1.2, D5.2, D6.2, D17.2, D18.2, J4.1, J4.2, J4.3, J5.2, J6.4, J6.MP, J7.6, J7.MP, J8.5, J8.MP, J9.3, J9.MP, J10.MP, J11.3, J11.MP, P1.5, Q2.2, R14.2, R17.2, R21.2, R24.2, R26.2, R31.2, R32.2, R38.2, U1.43, U1.49, U2.2, U3.5, U4.2, U5.5, U6.2, U6.3, U6.5, U7.2, U7.3, U7.5, U8.2, U9.2, U10.9, U10.10, U11.2
HALL1: R27.2, U1.36, U9.6
HALL2: R28.2, U1.37, U9.1
HALL3: R29.2, U1.38, U9.3
IUH: C17.1, J2.3, U1.10
IUL: C17.2, J2.2, U1.9
IVH: C18.1, J3.3, U1.8
IVL: C18.2, J3.2, U1.7
IWH: C19.1, J1.3, U1.6
IWL: C19.2, J1.2, U1.5
NTC_EXT: C39.1, D19.2, J5.1, J10.2, R20.2, R39.2, U8.6
NTC_EXT_GND: J10.1, Q2.3
NTC_IO: R39.1, U1.45
unnamed: C2.2, D3.2, J2.5, R2.1
unnamed: C3.1, D4.2, J2.4, R3.1
unnamed: C13.2, D8.2, J3.5, R10.1
unnamed: C14.1, D9.2, J3.4, R11.1
unnamed: C15.2, D11.2, J1.5, R12.1
unnamed: C16.1, D12.2, J1.4, R13.1
unnamed: C20.1, C21.1, C32.1, D13.1, R16.2, R36.2, U10.4
unnamed: C32.2, D16.1, R36.1
unnamed: C35.1, U3.6
unnamed: C35.2, D18.1, L1.1, U3.1
unnamed: C40.1, D19.1, Q2.1, R21.1
unnamed: D14.2, U10.7, U10.8
unnamed: D16.2, Q1.3, U10.3
unnamed: J6.1, JP2.2
unnamed: J8.2, R27.1, R35.2
unnamed: J8.3, R28.1, R34.2
unnamed: J8.4, R29.1, R33.2
unnamed: J9.2, R45.2, R46.2
unnamed: Q1.2, R15.2
unnamed: R7.2, U1.16
unnamed: R32.1, U2.8
unnamed: R37.2, R38.1, U3.4
RS485RXTX: U1.40, U5.2, U5.3
SK6812: D17.3, U1.33
SK6812_OUT: D17.1, J11.2
SWDCL: P1.4, U1.3, U8.3
SWDIO: P1.2, U1.46, U8.1
U: C2.1, J2.6, R1.1, R23.1
UU: C29.1, R23.2, R24.1, U1.12
UV: C30.1, R25.2, R26.1, U1.13
UW: C31.1, R30.2, R31.1, U1.14
V: C13.1, J3.6, R8.1, R25.1
VCC18: C6.1, U1.41
VCORE: C7.1, U1.42
VHM: C22.1, C23.1, D15.1, R16.1, U1.19
VIN: D13.2, J5.3, R6.1
VIO: C4.1, C5.1, C8.1, J9.1, JP2.1, P1.1, R33.1, R34.1, R35.1, R46.1, U1.44, U4.4
VP: C25.1, C27.1, C33.1, D2.2, D7.2, D10.2, D14.1, D15.2, U1.18, U3.2
VSYS: R7.1, U1.15
Vin_mon: C42.1, R6.2, R17.1, U1.47
W: C15.1, J1.6, R9.1, R30.1
