Jana-Marie/OtterControlNG/AluPCB/AluPCB.kicad_pcb

## KiCad design AluPCB/AluPCB.kicad_pcb (2019-05-14)

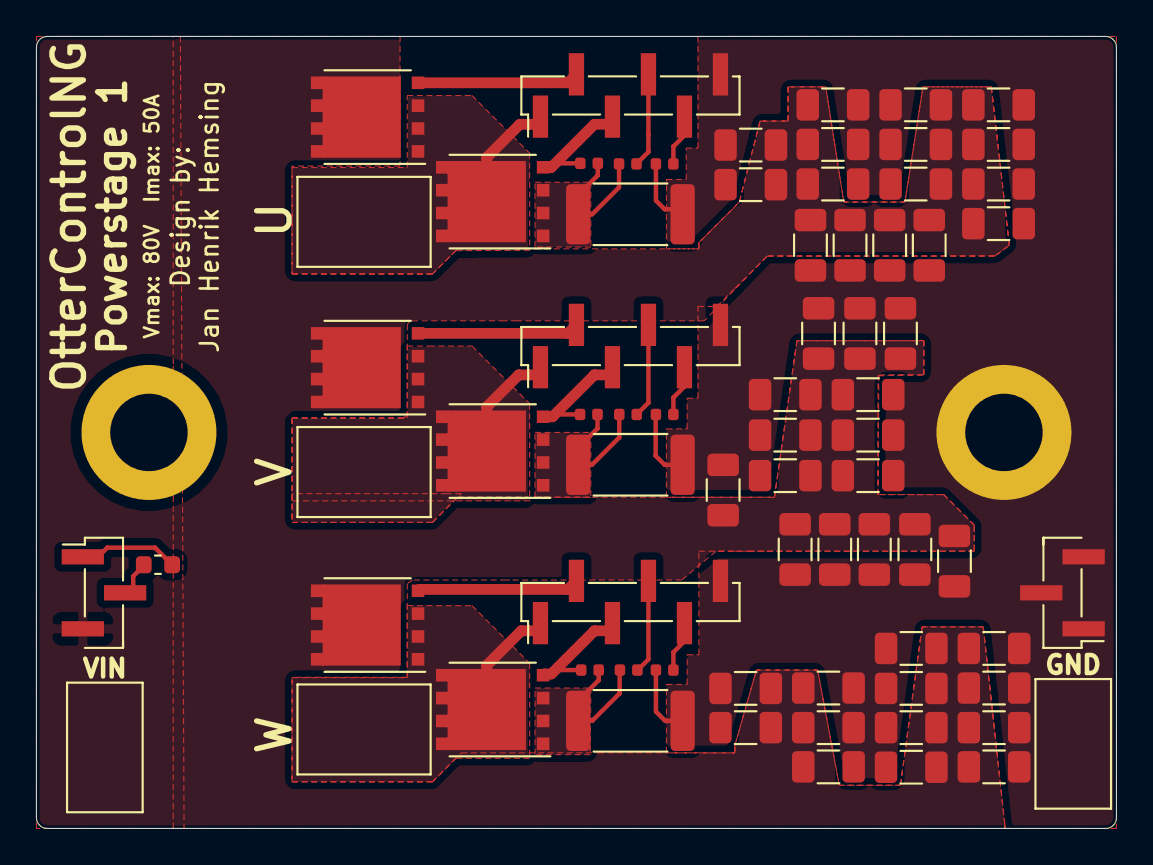
[picture p17: board AluPCB.kicad_pcb from above]

Board: 2 copper layers, 60.0 x 44.0 mm, 70 parts (0 on the bottom side), 22 nets.

Parts:
C1, C2, C3, C5, C7, C9, C11, C14, C15, C20, C21, C22, C23, C25, C26, C28, C29, C31, C32, C33, C34, C35, C36, C37, C38, C39, C40, C41, C42, C43, C44, C45, C47, C48, C49, C50, C52, C53, C54, C55, C56, C58, C59, C60: 2u2; C_1206_3216Metric
H1, H2: MountingHole_Pad; MountingHole_4.3mm_M4_DIN965_Pad
J1, J2, J3: CON_U; PinHeader_1x06_P2.00mm_Vertical_SMD_Pin1Left
J4: GND; PinHeader_1x03_P2.00mm_Vertical_SMD_Pin1Left
J5: VIN; PinHeader_1x03_P2.00mm_Vertical_SMD_Pin1Left
Q1, Q2, Q3, Q4, Q5, Q6: AON6276; VSONP-8-1EP_5x6_P1.27mm
R1, R4, R7: R001; R_2512_6332Metric
R2, R3, R5, R6, R8, R9: 100; R_0402_1005Metric
R10, R11, R12: 10k; R_0402_1005Metric
TH1: 10k; R_0603_1608Metric

Connections:
GND: C1.2, C2.2, C3.2, C5.2, C7.2, C9.2, C11.2, C14.2, C15.2, C20.2, C21.2, C22.2, C23.2, C25.2, C26.2, C28.2, C29.2, C31.2, C32.2, C33.2, C34.2, C35.2, C36.2, C37.2, C38.2, C39.2, C40.2, C41.2, C42.2, C43.2, C44.2, C45.2, C47.2, C48.2, C49.2, C50.2, C52.2, C53.2, C54.2, C55.2, C56.2, C58.2, C59.2, C60.2, H2.1, J1.6, J2.6, J3.6, J4.1, J4.2, J4.3, R1.2, R3.2, R4.2, R6.2, R7.2, R9.2
GUH: J1.2, Q1.2
GUL: J1.3, Q2.2, R10.2
GVH: J2.2, Q3.2
GVL: J2.3, Q4.2, R11.2
GWH: J3.2, Q5.2
GWL: J3.3, Q6.2, R12.2
IUH: J1.4, R2.1
IUL: J1.5, R3.1
IVH: J2.4, R5.1
IVL: J2.5, R6.1
IWH: J3.4, R8.1
IWL: J3.5, R9.1
unnamed: J5.1, TH1.2
unnamed: J5.2, TH1.1
unnamed: Q2.1, R1.1, R2.2, R10.1
unnamed: Q4.1, R4.1, R5.2, R11.1
unnamed: Q6.1, R7.1, R8.2, R12.1
U: J1.1, Q1.1, Q2.3
V: J2.1, Q3.1, Q4.3
VIN: C1.1, C2.1, C3.1, C5.1, C7.1, C9.1, C11.1, C14.1, C15.1, C20.1, C21.1, C22.1, C23.1, C25.1, C26.1, C28.1, C29.1, C31.1, C32.1, C33.1, C34.1, C35.1, C36.1, C37.1, C38.1, C39.1, C40.1, C41.1, C42.1, C43.1, C44.1, C45.1, C47.1, C48.1, C49.1, C50.1, C52.1, C53.1, C54.1, C55.1, C56.1, C58.1, C59.1, C60.1, J5.3, Q1.3, Q3.3, Q5.3
W: J3.1, Q5.1, Q6.3
