Jana-Marie/OtterControlNG/(commit log)

2019-04-28 updated connectors
    [PAC5523.sch]
2019-04-28 schematic cleanup, added PDF
    [IC.sch, PAC5523.sch, con.sch]
2019-04-28 updated schematic
    [IC.sch, con.sch]
2019-04-28 moved files
    [AluPCB.kicad_pcb, AluPCB.sch]
2019-04-28 aluPCB V1
    [AluPCB.kicad_pcb, AluPCB.sch]
2019-04-28 finished AluPCB Power Stage 1, added images
    [AluPCB.kicad_pcb, AluPCB.sch]
2019-05-05 updated PCB, changed size to 44x50mm
    [AluPCB.kicad_pcb]
2019-05-05 finished ALUpcb
    [AluPCB.kicad_pcb]
2019-05-14 finalized Powerstage, ordered PCBs
    [AluPCB.kicad_pcb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]
2019-05-14 added Encoder,LED,NTC
    [IC.sch, PAC5523.sch, con.sch]
2019-05-15 placement almost done
    [IC.sch, PAC5523.kicad_pcb, PAC5523.sch, con.sch]
2019-05-15 routing 60% done
    [PAC5523.kicad_pcb, PAC5523.sch, con.sch]
2019-05-20 finalized board, silkscreen needs some work
    [IC.sch, PAC5523.kicad_pcb, PAC5523.sch, con.sch]
2019-05-20 finalized silkscreen
    [PAC5523.kicad_pcb, con.sch]
2019-05-22 finalized silkscreen, generated gerber
    [IC.sch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]
2019-07-11 added notes
    [PAC5523.kicad_pcb]
2019-07-22 added gerber
    [AluPCB.sch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]
2019-11-15 added stm32G431
    [IC.sch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]
2019-11-17 updated files
    [PAC5523.kicad_pcb, PAC5523.sch, con.sch]
2019-12-10 updated pcb
    [BOM.csv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]
2019-12-15 remaned files
    [BOM.csv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]
2019-12-15 removed old files
    [PAC5523.kicad_pcb, PAC5523.sch]
2019-12-15 updated layout
    [STM32G431.kicad_pcb, con.sch]
2020-01-31 added image
    [BOM.csv, STM32G431.kicad_pcb]
